stuartpittaway/OeMRFM69_USB/README.md

# OeMRFM69_USB
RFM69CW wireless interface over serial USB (for Open Energy Monitor Project)
