stuartpittaway/OeMRFM69_USB/PCB/OeMRFM69_USB.kicad_pcb

## KiCad design PCB/OeMRFM69_USB.kicad_pcb (2023-08-30)

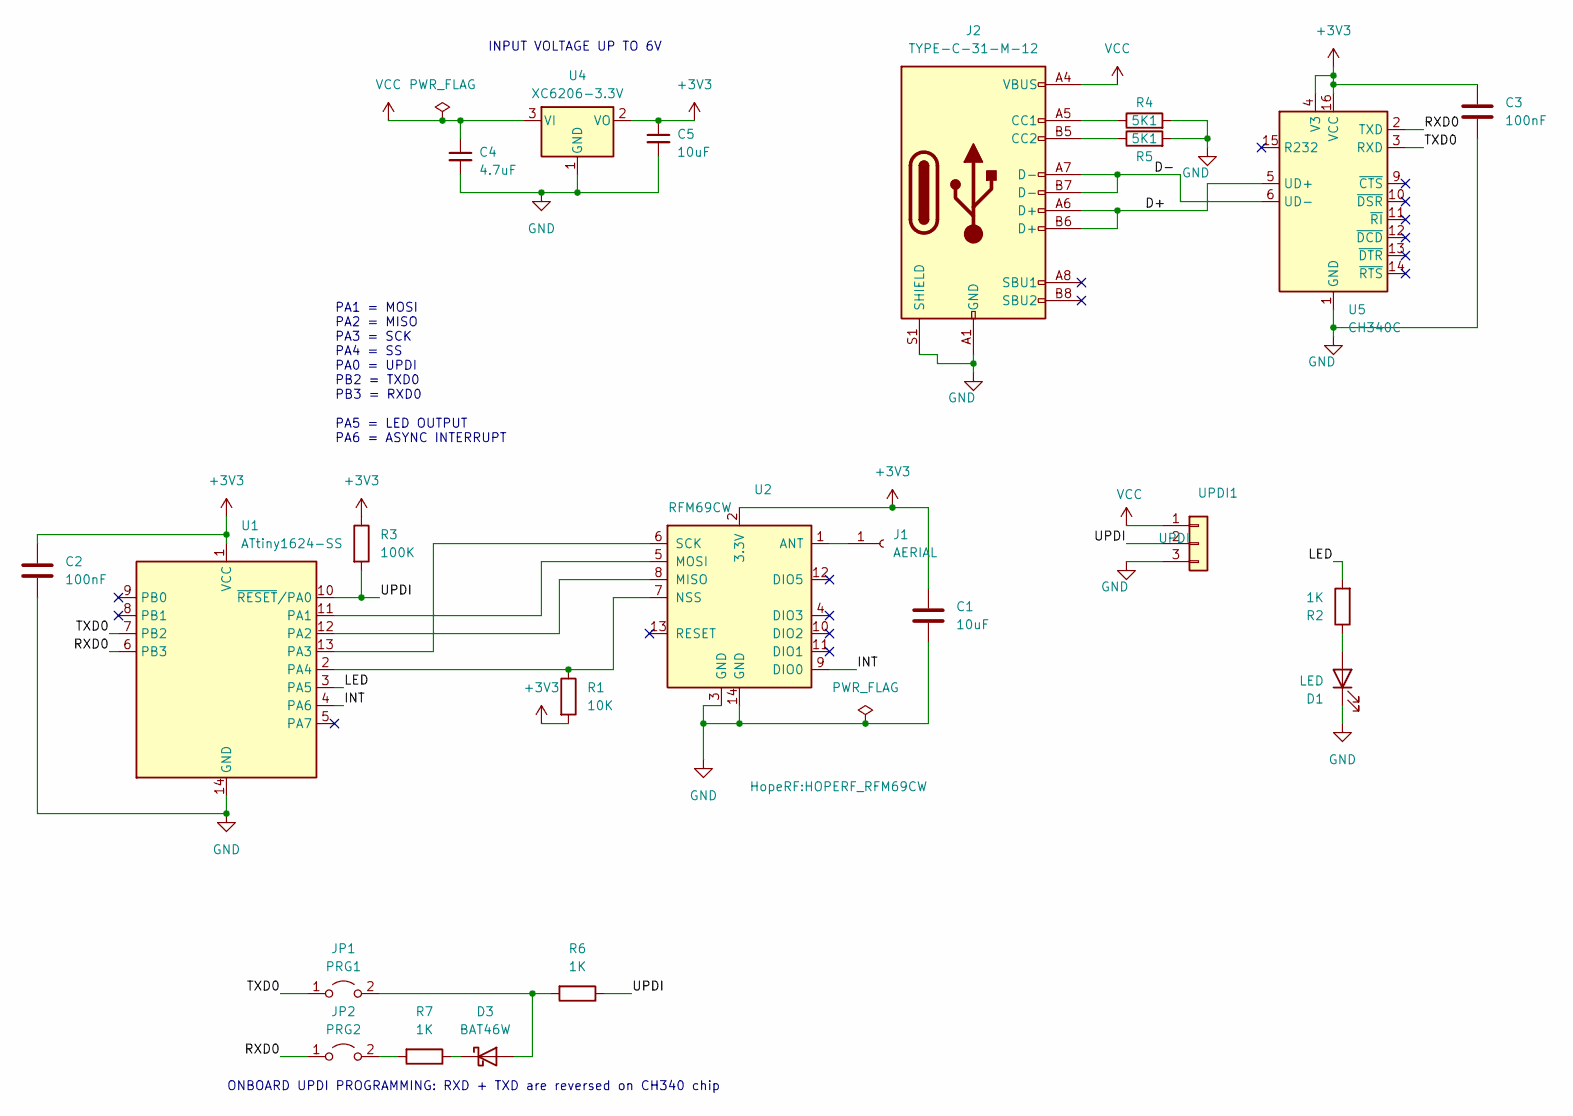
[picture p1: schematic OeMRFM69_USB.kicad_sch]

Parts:
C1, C5: 10uF; C_0805_2012Metric; PartNumber CL21A106KAYNNNE; LCSCStockCode C15850
C2, C3: 100nF; C_0805_2012Metric; PartNumber CC0805KRX7R9BB104; LCSCStockCode C49678
C4: 4.7uF; C_0805_2012Metric; PartNumber CL21A475KAQNNNE; LCSCStockCode C1779
D1: LED; LED_0805_2012Metric; PartNumber NCD0805R1; LCSCStockCode C84256
D3: BAT46W; D_SOD-123; PartNumber BAT46W; LCSCStockCode C54110
J1: AERIAL; PinHeader_1x01_P2.54mm_Vertical
J2: TYPE-C-31-M-12; PartNumber TYPE-C-31-M-12; LCSCStockCode C165948
JP1: PRG1; PinHeader_1x02_P2.54mm_Vertical; PartNumber KH-A2541WV-2P; LCSCStockCode C2833329
JP2: PRG2; PinHeader_1x02_P2.54mm_Vertical; PartNumber KH-A2541WV-2P; LCSCStockCode C2833329
R1: 10K; R_0805_2012Metric; PartNumber 0805W8F1002T5E; LCSCStockCode C17414
R2, R6, R7: 1K; R_0805_2012Metric; PartNumber 0805W8F1001T5E; LCSCStockCode C17513
R3: 100K; R_0805_2012Metric; PartNumber 0805W8F1003T5E; LCSCStockCode C149504
R4, R5: 5K1; R_0805_2012Metric; PartNumber 0805W8F5101T5E; LCSCStockCode C27834
U1: ATtiny1624-SS; SOIC-14_3.9x8.7mm_P1.27mm; PartNumber ATTINY1624-SS; LCSCStockCode C5160891
U2: RFM69CW; HOPERF_RFM69CW
U4: XC6206-3.3V; SOT-23-3; PartNumber XC6206-3.3V; LCSCStockCode C2891841
U5: CH340C; SOIC-16_3.9x9.9mm_P1.27mm; PartNumber CH340C; LCSCStockCode C84681
UPDI1: UPDI; PinSocket_1x03_P2.54mm_Vertical

Connections:
+3V3: C1.1, C2.1, C3.1, C5.1, R1.2, R3.1, U1.1 (VCC), U2.2 (3.3V), U4.2 (VO), U5.4 (V3), U5.16 (VCC)
/D+: J2.A6 (D+), J2.B6 (D+), U5.5 (UD+)
/D-: J2.A7 (D-), J2.B7 (D-), U5.6 (UD-)
/INT: U1.4 (PA6), U2.9 (DIO0)
/LED: R2.2, U1.3 (PA5)
/RXD0: JP2.1 (A), U1.6 (PB3), U5.2 (TXD)
/TXD0: JP1.1 (A), U1.7 (PB2), U5.3 (RXD)
/UPDI: R3.2, R6.1, U1.10 (~RESET/PA0), UPDI1.2
GND: C1.2, C2.2, C3.2, C4.2, C5.2, D1.1 (K), J2.A1 (GND), J2.A12 (GND), J2.B1 (GND), J2.B12 (GND), J2.S1 (SHIELD), R4.2, R5.2, U1.14 (GND), U2.3 (GND), U2.14 (GND), U4.1 (GND), U5.1 (GND), UPDI1.3
unnamed: D1.2 (A), R2.1
unnamed: D3.2 (A), JP1.2 (B), R6.2
unnamed: D3.1 (K), R7.1
unnamed: J1.1, U2.1 (ANT)
unnamed: J2.A5 (CC1), R4.1
unnamed: J2.B5 (CC2), R5.1
unnamed: JP2.2 (B), R7.2
unnamed: U1.11 (PA1), U2.5 (MOSI)
unnamed: U1.12 (PA2), U2.8 (MISO)
unnamed: U1.13 (PA3), U2.6 (SCK)
unnamed: R1.1, U1.2 (PA4), U2.7 (NSS)
VCC: C4.1, J2.A4 (VBUS), J2.A9 (VBUS), J2.B4 (VBUS), J2.B9 (VBUS), U4.3 (VI), UPDI1.1

Notes on the sheet:
ONBOARD UPDI PROGRAMMING: RXD + TXD are reversed on CH340 chip
PA1 = MOSI PA2 = MISO PA3 = SCK PA4 = SS PA0 = UPDI PB2 = TXD0 PB3 = RXD0 PA5 = LED OUTPUT PA6 = ASYNC INTERRUPT
INPUT VOLTAGE UP TO 6V

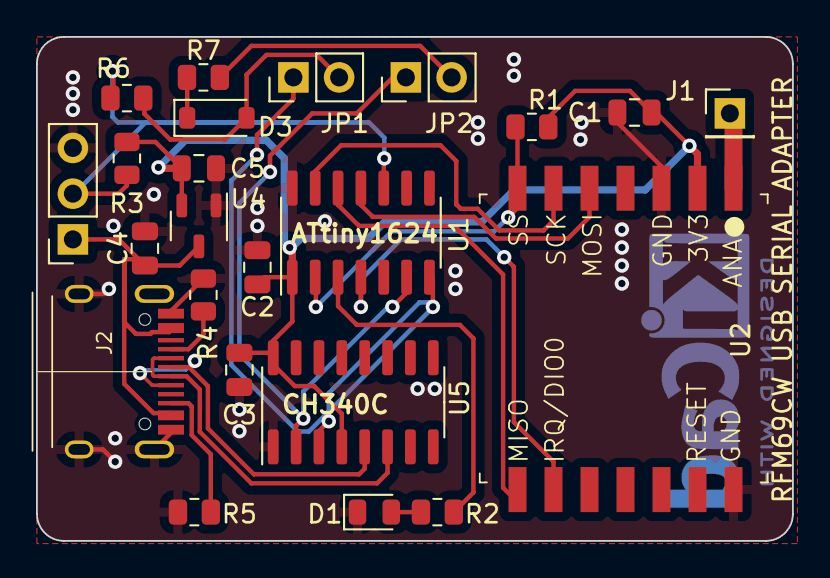
[picture p2: board OeMRFM69_USB.kicad_pcb from above]

Board: 2 copper layers, 42.0 x 28.0 mm, 23 parts (0 on the bottom side), 21 nets.
