stuartpittaway/OeMRFM69_USB/(commit log)

2023-08-01 First check in
    [OeMRFM69_USB.kicad_pcb, OeMRFM69_USB.kicad_sch]
2023-08-01 Add hash silkscreen stamp
    [OeMRFM69_USB.kicad_pcb]
2023-08-01 Updated BOM
    [OeMRFM69_USB.kicad_pcb, OeMRFM69_USB.kicad_sch]
2023-08-30 RFM69 footprint changes
    [OeMRFM69_USB.kicad_pcb]
